curiouselectric/EMFDetector/EMF Detector-Instructions/Photos/pp31.jpg

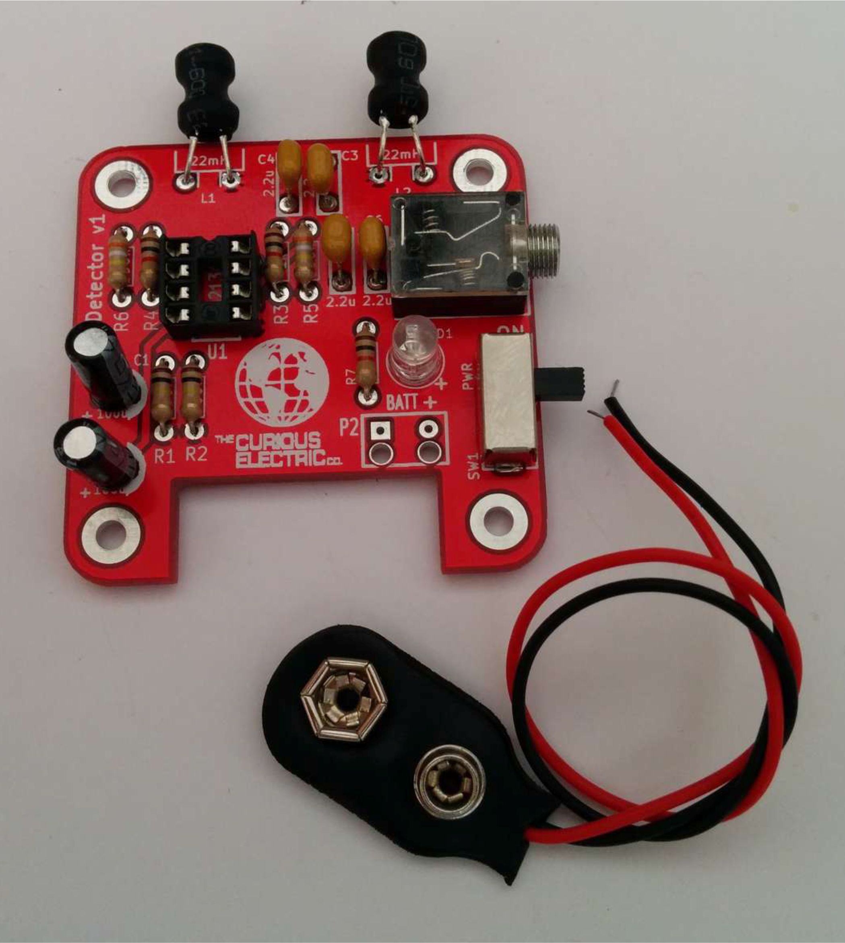
EMF Detector-Instructions/Photos/pp31.jpg
