curiouselectric/EMFDetector/EMF Detector-Instructions/Photos/capacitors2.jpg

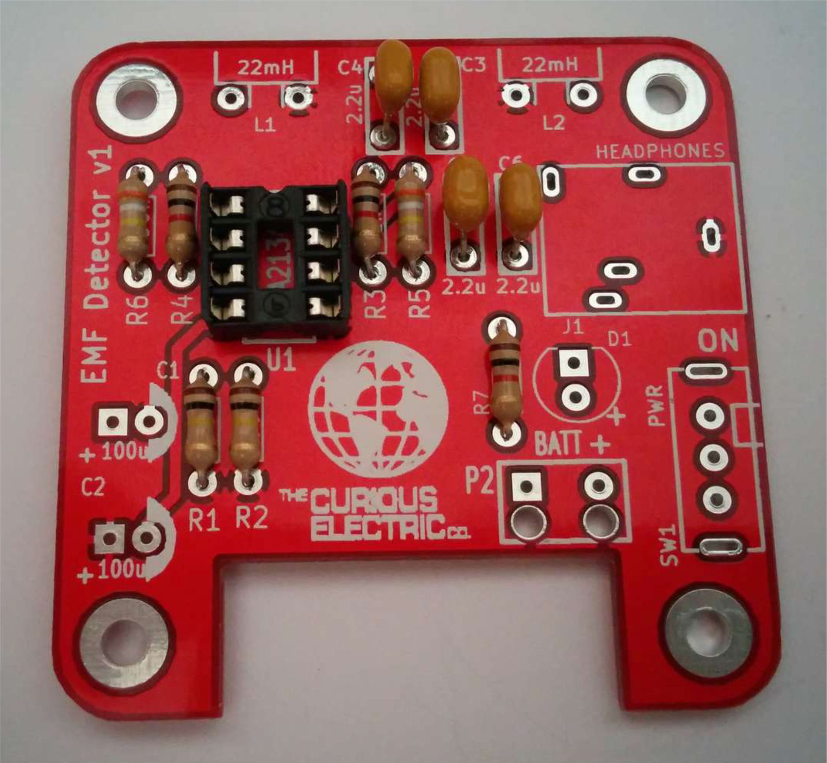
EMF Detector-Instructions/Photos/capacitors2.jpg
