curiouselectric/EMFDetector/README.md

# EMFDetector
A simple electro-magnetic field detector for viewing the unseen world around us.
