curiouselectric/EMFDetector/EMF Detector-Instructions/Photos/parts1.jpg

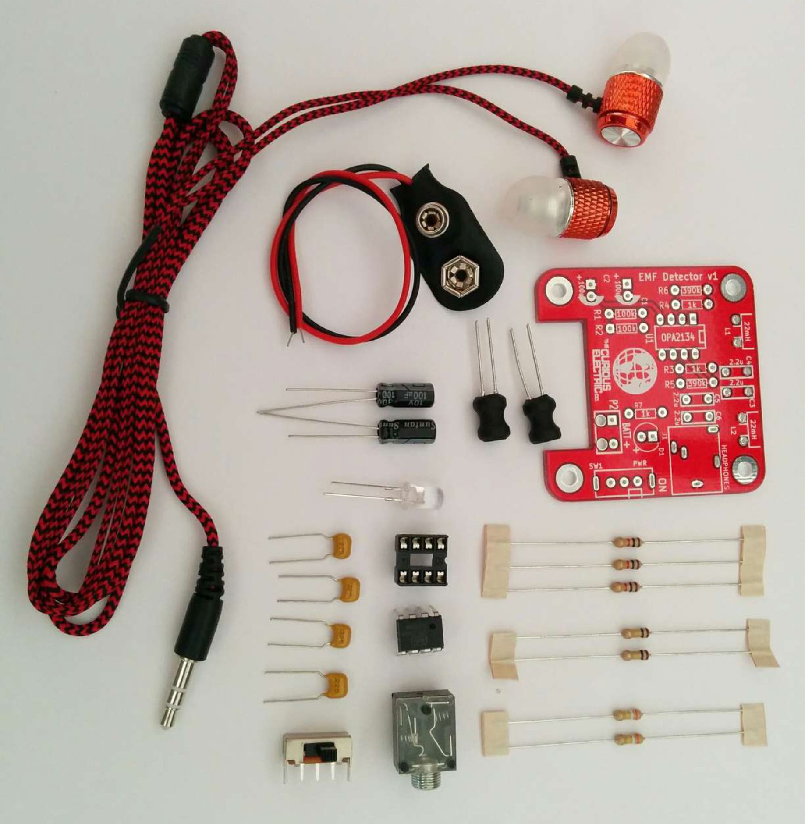
EMF Detector-Instructions/Photos/parts1.jpg
