curiouselectric/EMFDetector/EMF Detector-Instructions/Photos/parts1_1000x500.jpg

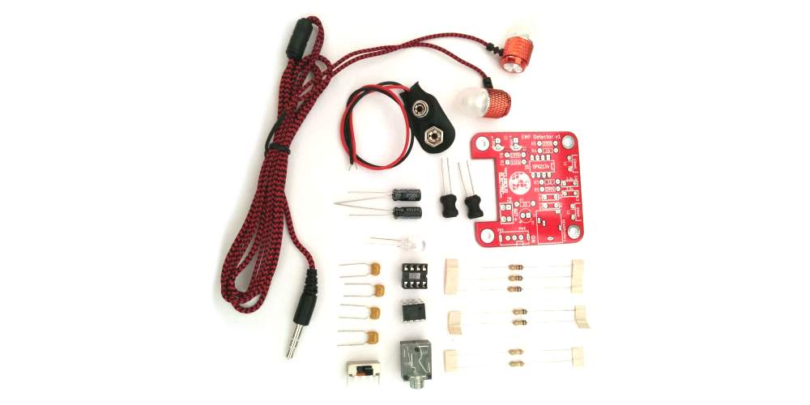
EMF Detector-Instructions/Photos/parts1_1000x500.jpg
