curiouselectric/EMFDetector/EMFDetector-Enclosure/EMFDetector2016 Enclosure v4.dxf

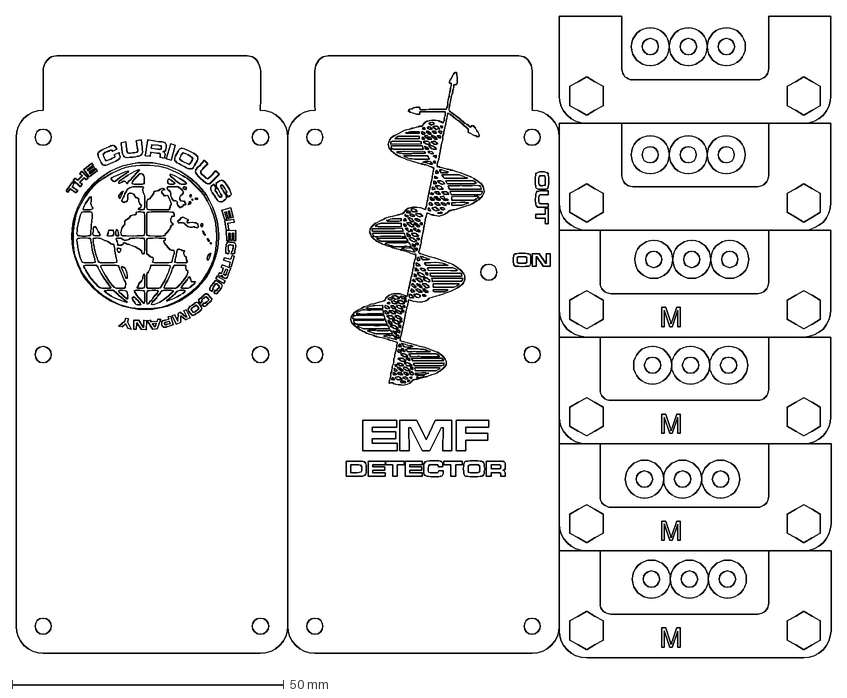
[picture p5: CAD file, 2017-03-24]
EMFDetector-Enclosure/EMFDetector2016 Enclosure v4.dxf
150.0 x 118.0 mm
