curiouselectric/EMFDetector/EMF Detector-Instructions/Photos/enclosure1.jpg

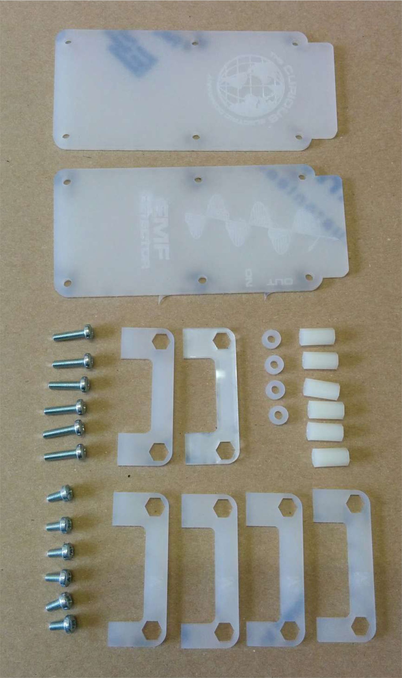
EMF Detector-Instructions/Photos/enclosure1.jpg
