curiouselectric/EMFDetector/EMF Detector-Instructions/Photos/enclosure1_1000x500.jpg

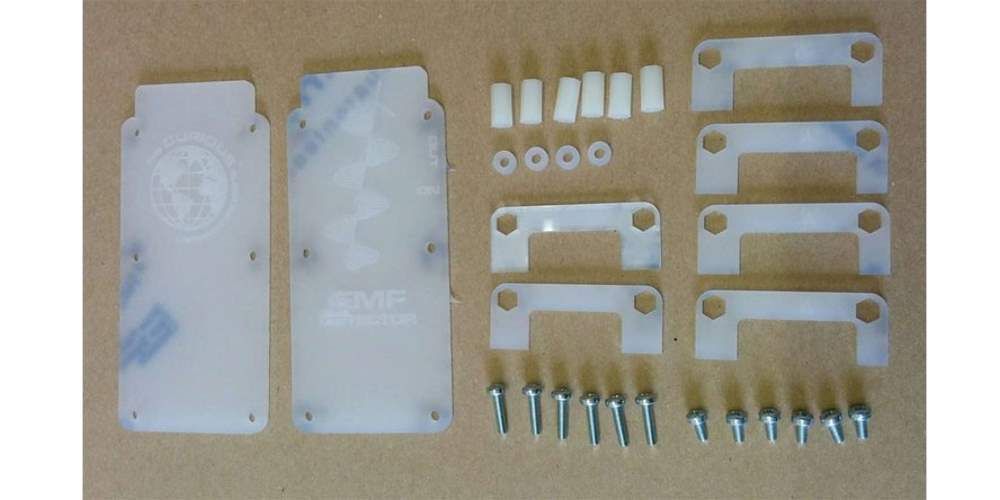
EMF Detector-Instructions/Photos/enclosure1_1000x500.jpg
