curiouselectric/EMFDetector/EMF Detector-Instructions/Photos/enclosure11_1000x500.jpg

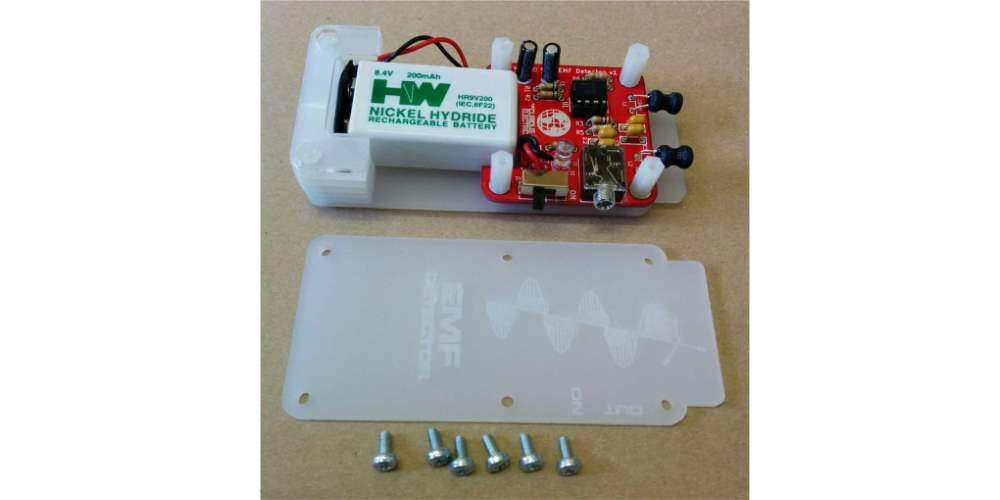
EMF Detector-Instructions/Photos/enclosure11_1000x500.jpg
