curiouselectric/EMFDetector/EMF Detector-Instructions/Photos/enclosure12.jpg

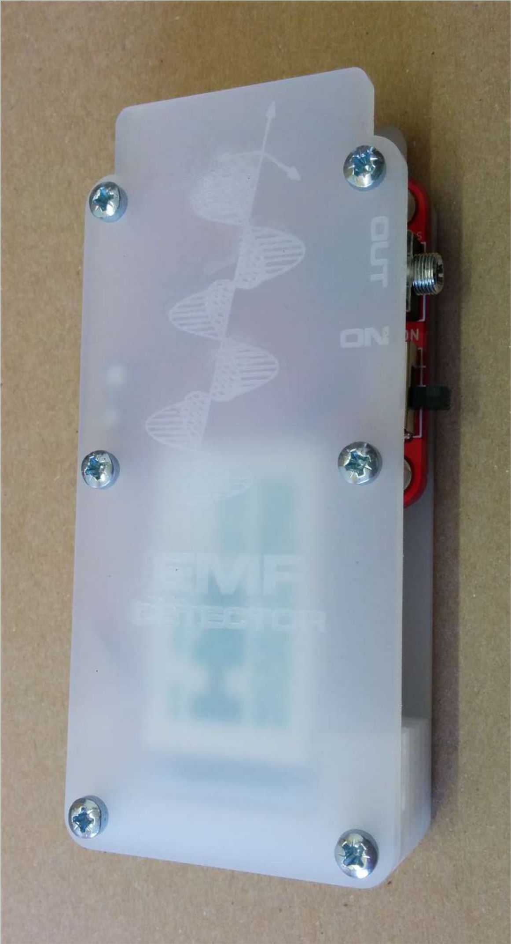
EMF Detector-Instructions/Photos/enclosure12.jpg
