curiouselectric/EMFDetector/EMF Detector-Instructions/Photos/enclosure13_1000x500.jpg

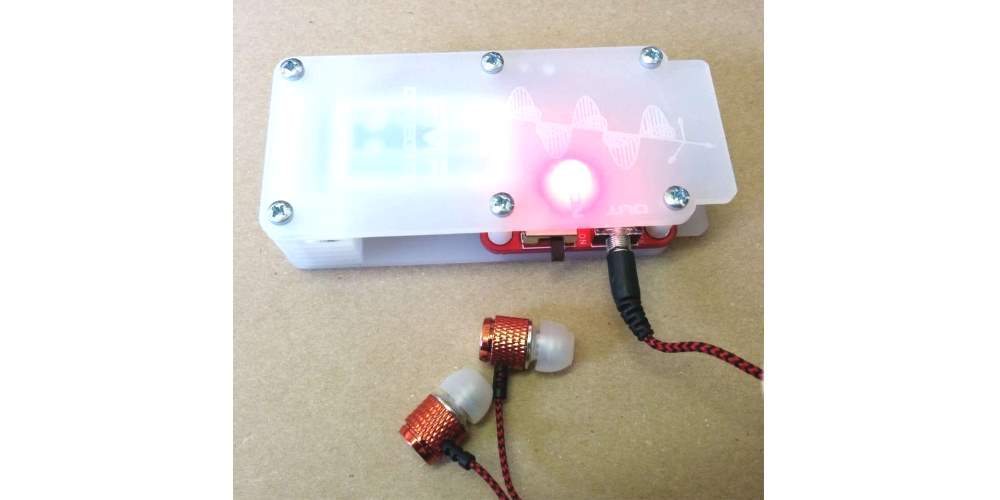
EMF Detector-Instructions/Photos/enclosure13_1000x500.jpg
