curiouselectric/EMFDetector/EMF Detector-Instructions/Photos/enclosure13_web.jpg

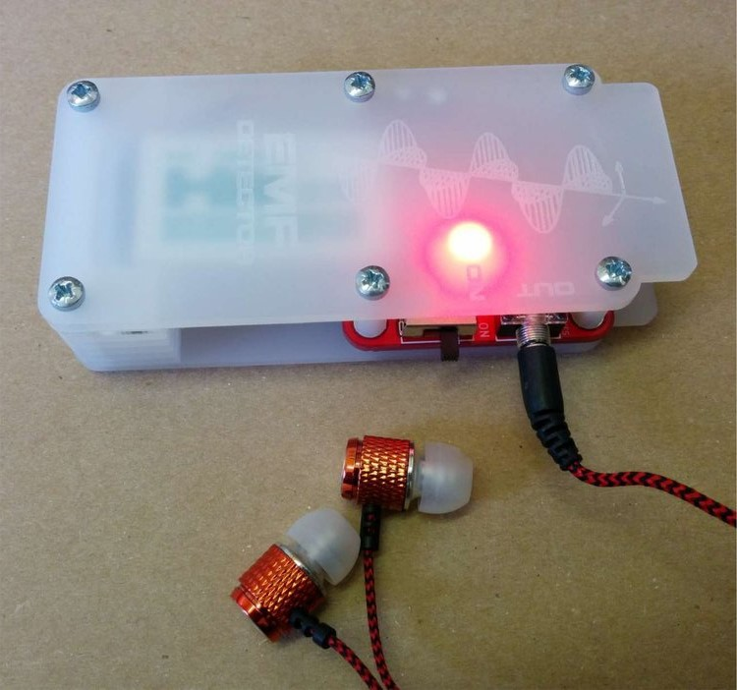
EMF Detector-Instructions/Photos/enclosure13_web.jpg
