curiouselectric/EMFDetector/EMF Detector-Instructions/Photos/enclosure14_1000x500.jpg

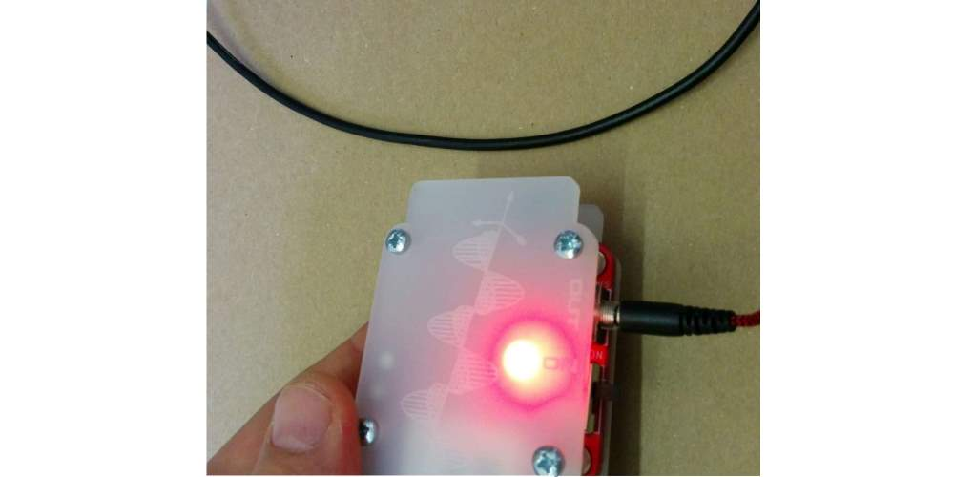
EMF Detector-Instructions/Photos/enclosure14_1000x500.jpg
