curiouselectric/EMFDetector/EMFDetector-PCB/Version_2/EMFDetector_v2.kicad_pcb

## KiCad design EMFDetector-PCB/Version_2/EMFDetector_v2.kicad_pcb (2025-08-26)

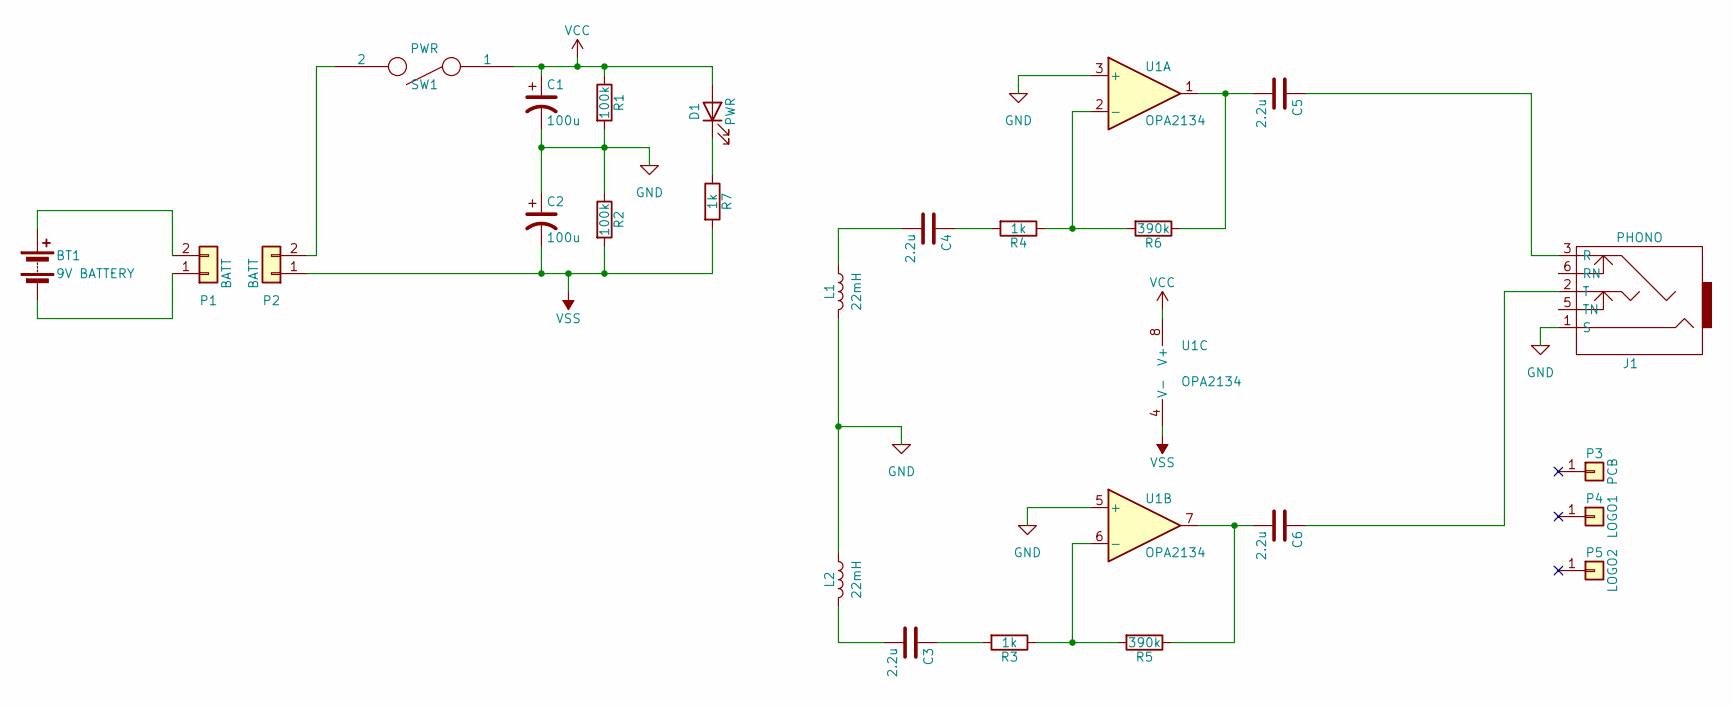
[picture p90: schematic EMFDetector_v2.kicad_sch]

Parts:
BT1: 9V BATTERY
C1, C2: 100u; C_1V7_TH
C3, C4, C5, C6: 2.2u; C1_wide_lg_pad
D1: PWR; TH_LED-5MM_larg_pad
J1: PHONO; TH_3_5mm_Jack_oval_holes
L1, L2: 22mH; TH_Inductor
P1: BATT
P2: BATT; Batt_Connector_Strain_Relief
P3: PCB; PCB_50x50mm
P4: LOGO1; TCEC_Words_13mm
P5: LOGO2; CuriousElectric_globe_10mm
R1, R2: 100k; TH_Resistor_1
R3, R4, R7: 1k; TH_Resistor_1
R5, R6: 390k; TH_Resistor_1
SW1: PWR; SW_SPDT_R_Angle_ALIEX
U1: OPA2134; DIP-8_300_ELL

Connections:
GND: C1.2, C2.1, J1.1 (S), L1.2, L2.1, R1.2, R2.1, U1.3 (+), U1.5 (+)
unnamed: BT1.1 (+), P1.2
unnamed: BT1.2 (-), P1.1
unnamed: C3.1, R3.2
unnamed: C3.2, L2.2
unnamed: C4.1, R4.2
unnamed: C4.2, L1.1
unnamed: C5.1, J1.3 (R)
unnamed: C5.2, R6.1, U1.1
unnamed: C6.1, J1.2 (T)
unnamed: C6.2, R5.1, U1.7
unnamed: D1.1 (K), R7.1
unnamed: P2.2, SW1.2
unnamed: R3.1, R5.2, U1.6 (-)
unnamed: R4.1, R6.2, U1.2 (-)
VCC: C1.1, D1.2 (A), R1.1, SW1.1, U1.8 (V+)
VSS: C2.2, P2.1, R2.2, R7.2, U1.4 (V-)

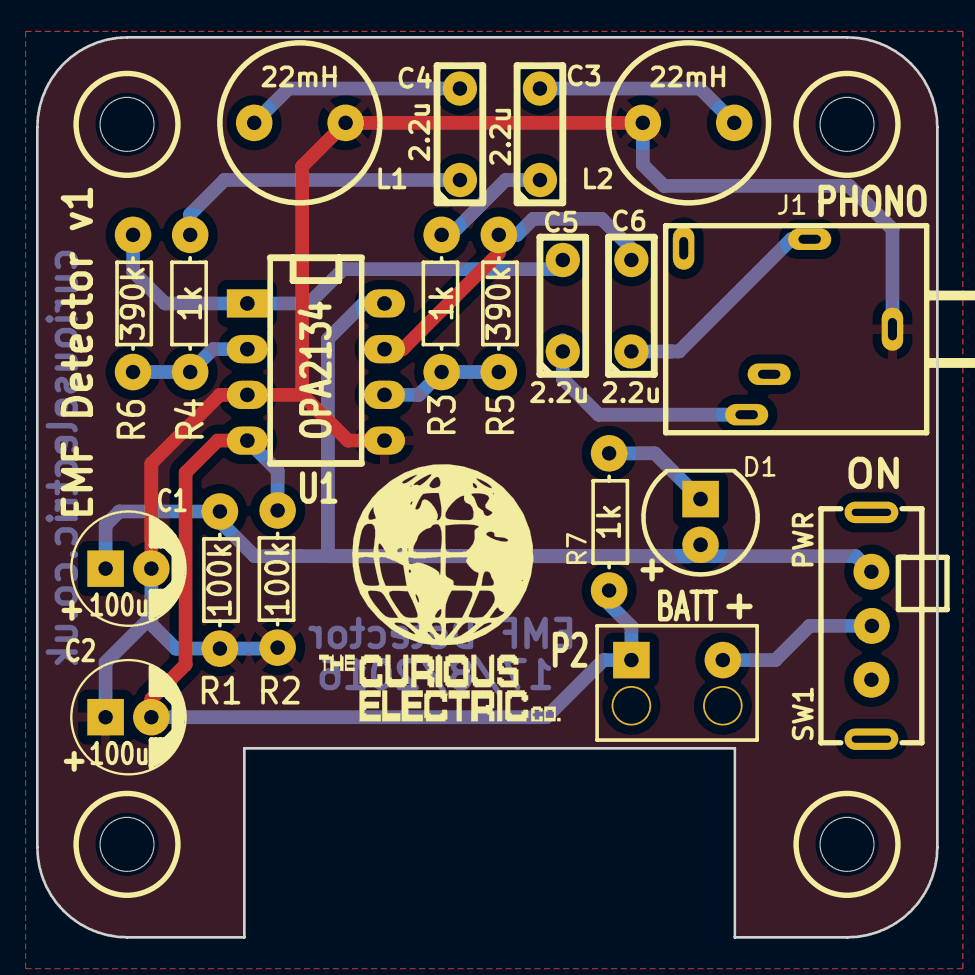
[picture p91: board EMFDetector_v2.kicad_pcb from above]

Board: 2 copper layers, 50.0 x 50.0 mm, 23 parts (0 on the bottom side), 15 nets.
