curiouselectric/EMFDetector/(commit log)

2017-03-24 First upload of info
    [EMFDetector.kicad_pcb, EMFDetector.sch, EMFDetector2016 Enclosure v4.dxf]
2017-08-18 Updated instructions etc
    [EMFDetector.kicad_pcb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]
2021-07-04 redone PCB with newer Kicad models
    [EMFDetector.kicad_pcb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]
2021-07-25 New version of PCB built for new kicad version
    [EMFDetector_v2.kicad_pcb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]
2026-02-17 Updated enclosure files
